andrewerrington/challenger_300_glareshield/README.md

# challenger_300_glareshield
Project to interface the Challenger 300 glare shield panel to X-Plane flight simulator.
