andrewerrington/challenger_300_glareshield/mcp/mcp.png

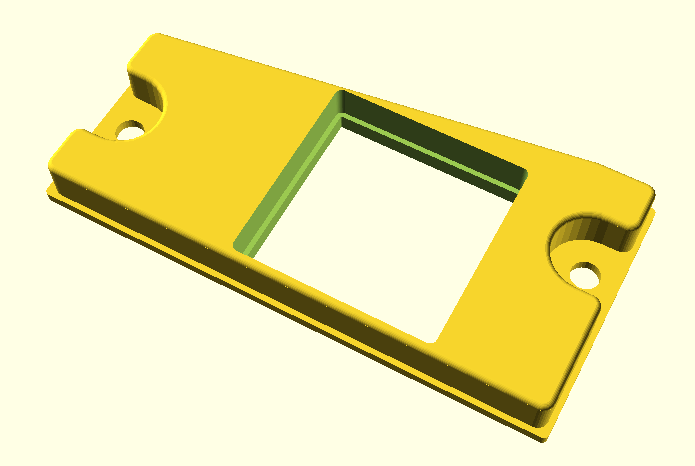
mcp/mcp.png
