andrewerrington/challenger_300_glareshield/mcp/mcp_bom.md

# Challenger 300 MCP panel parts		

Parts list is for one panel. Make two assemblies, mirror images of each other for Pilot (left) and Co-Pilot/FO (right).

Choose lasercut parts _or_ 3D printed part. Note that example links are for illustration only and should not be considered an endorsement of the product or supplier.

Lasercut panel assembly (from `mcp.dxf`)
|Qty | Description | Notes | Example link |
| --- | --- | --- | --- |
| 1	| Panel cut from 1.5mm (1/16”) acrylic | 1.5mm, 1.6mm or 1/16” material ok. Use _panel_, _panel_cut_, and _fasteners_panel_ layers.|
| 1	| Intermediate fascia piece cut from 3mm (1/8”) MDF | 3mm, 3.2mm, or 1/8” material ok. Use _fascia_outline_, _fascia_cut_, and _fasteners_fascia_ layers. |
| 1 | Top fascia piece cut from 3mm (1/8”) MDF | 3mm, 3.2mm, or 1/8” material ok. Use _fascia_outline_ and _fascia_cut_ layers. |
| 1 | Switch spacer cut from 1mm acrylic | Use _fascia_cut_ and _panel_cut_ layers to make thin, square spacer/packer. |
| 2 | M3x6 self-tapping screw | Attach panel to fascia. | https://www.aliexpress.com/item/1005003414944213.html
| 2 | M3x8 self-tapping screw | Hold perf board mount. | https://www.aliexpress.com/item/1005003414944213.html

or

3D printed panel assembly (from `mcp.stl`, created by `mcp.scad`)
|Qty | Description | Notes | Example link |
| --- | --- | --- | --- |
| 1 | 3D printed panel | Print `mcp.stl`. Mirror STL file for other side. |
| 2 | M3x8 self-tapping screw| Hold perf board mount. | https://www.aliexpress.com/item/1005003414944213.html

Common components
|Qty | Description | Notes | Example link |
| --- | --- | --- | --- |
| 1 | Perf board mount | Print from `perf_board_mount.stl`, any colour. |
| 1 | KF2510 header, right-angle, 4-way | For LEDs connection. | https://www.aliexpress.com/item/32963887703.html
| 1 | KF2510 header, right-angle, 2-way | For switch connection. | https://www.aliexpress.com/item/32963887703.html
| 1 | 2x8cm perfboard | Cut down to 7 holes long, plus edge with mounting holes. | https://www.aliexpress.com/item/1005006100148769.html
| 2 | 330R resistor | | https://www.aliexpress.com/item/1005005430821987.html
| 3 | LED, red, 3mm, ultra bright | | https://www.aliexpress.com/item/1954971920.html
| 3 | LED, yellow, 3mm, ultra bright | | https://www.aliexpress.com/item/1954971920.html
| | Thin hookup wire |
| 1 | 33mm square arcade button, white with black surround | | https://www.aliexpress.com/item/32708530409.html
| 2 | 4.8mm spade connector and wire | Optional | https://www.aliexpress.com/item/1005001851398735.html
| 1 | LED holder | Print from `mcp_LED_holder.stl`, cold white. |
| 1 | LED baffle | Print from `mcp_LED_baffle.stl`, black. |
| 2 | Opal acrylic 19x8.9x3mm | 3.2mm, or 1/8” material ok. Lasercut from `mcp_acrylic_insert.dxf` |
| 3 | Decal | Laser etch or print `mcp_decal.dxf` on laser transparency film and cut to 21.4x21.4mm. |
| 1 | Filter | Cut 21.4x21.4 mm square of 20% window tinting film. |
| 1	| KF2510 receptacle, 4-way | For LEDs connection. | https://www.aliexpress.com/item/32853172050.html
| 1 | KF2510 receptacle, 2-way | For switch connection. | https://www.aliexpress.com/item/32853172050.html
| 2 | DZUS fasteners | To suit sim panel construction technique. |
| 1 | Filing jig | Print from `mcp_filing_jig.stl`, any colour. Only one needed. |
| | | Spray paint: primer, matt white, matt black, matt clear, other colours as required.|
