andrewerrington/challenger_300_glareshield/COCKPIT_LIGHTS/COCKPIT_LIGHTS_fo.dxf

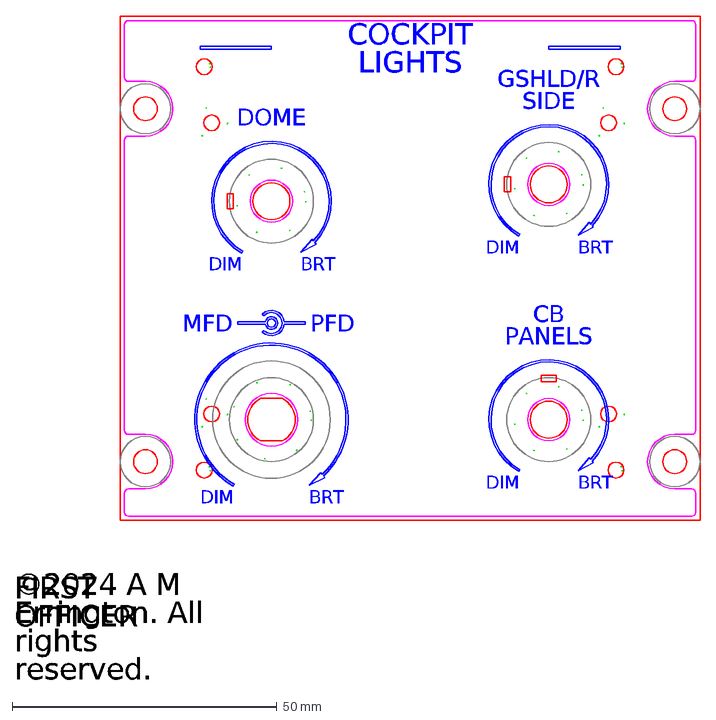
[picture p2: CAD file, 2024-09-26]
COCKPIT_LIGHTS/COCKPIT_LIGHTS_fo.dxf
COCKPIT LIGHTS
DOME
MFD
PFD
CB PANELS
GSHLD/R SIDE
DIM
BRT
FIRST OFFICER
©2024 A M Errington. All rights reserved.
