andrewerrington/challenger_300_glareshield/mcp/mcp_filing_jig.stl

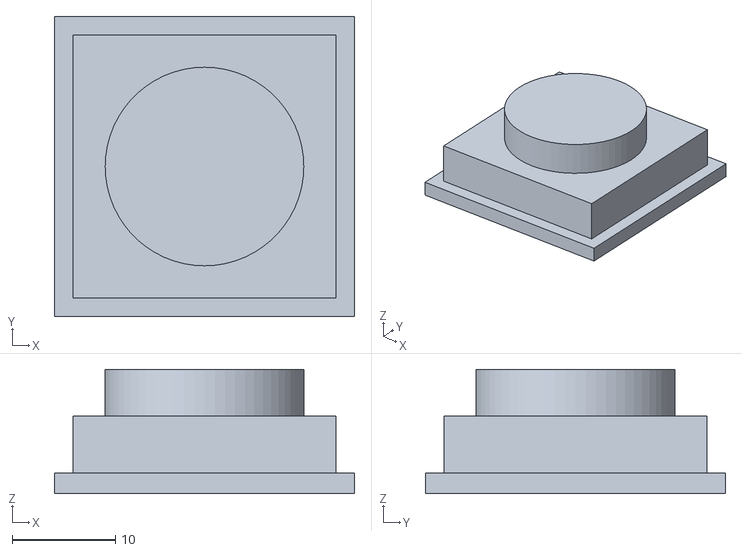
[picture p3: CAD file, 2024-04-25]
mcp/mcp_filing_jig.stl
29.0 x 29.0 x 12.0
