andrewerrington/challenger_300_glareshield/COCKPIT_LIGHTS/COCKPIT_LIGHTS_pilot.dxf

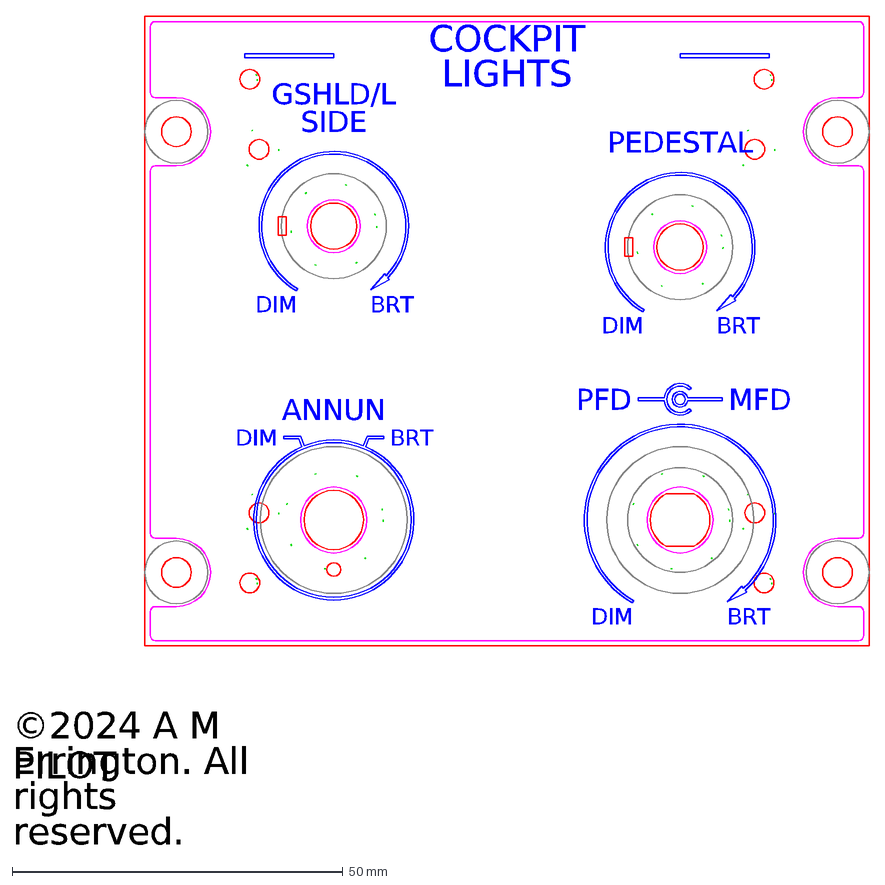
[picture p4: CAD file, 2024-09-26]
COCKPIT_LIGHTS/COCKPIT_LIGHTS_pilot.dxf
COCKPIT LIGHTS
PEDESTAL
MFD
PFD
ANNUN
GSHLD/L SIDE
DIM
BRT
PILOT
©2024 A M Errington. All rights reserved.
