andrewerrington/challenger_300_glareshield/mcp/mcp_decal.dxf

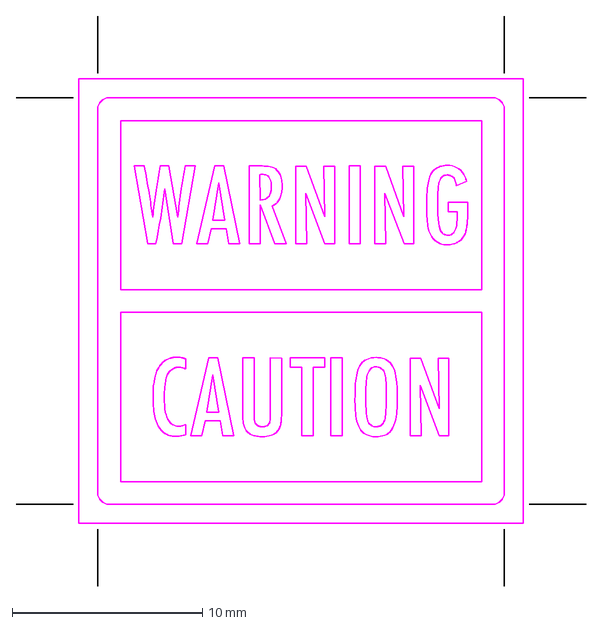
[picture p5: CAD file, 2024-04-25]
mcp/mcp_decal.dxf
30.0 x 30.0 mm
