andrewerrington/challenger_300_glareshield/mcp/mcp_acrylic_insert.dxf

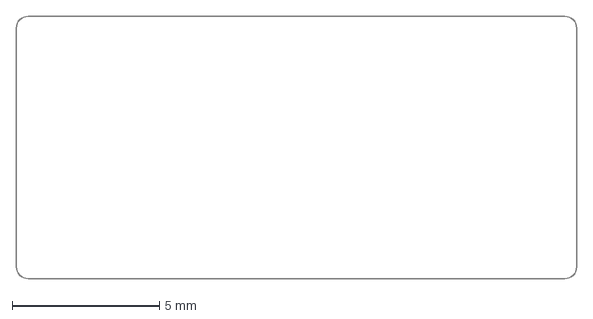
[picture p6: CAD file, 2024-04-25]
mcp/mcp_acrylic_insert.dxf
19.0 x 8.90 mm
