andrewerrington/challenger_300_glareshield/mcp/mcp_LED_holder.stl

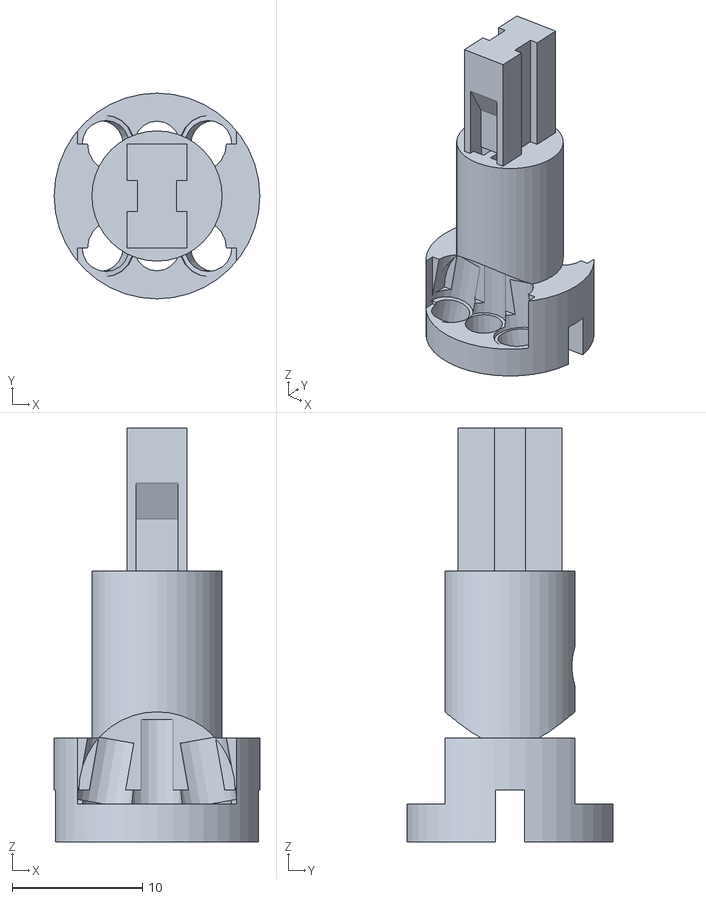
[picture p7: CAD file, 2024-04-25]
mcp/mcp_LED_holder.stl
15.8 x 15.8 x 31.8
