andrewerrington/challenger_300_glareshield/mcp/perf_board_mount.stl

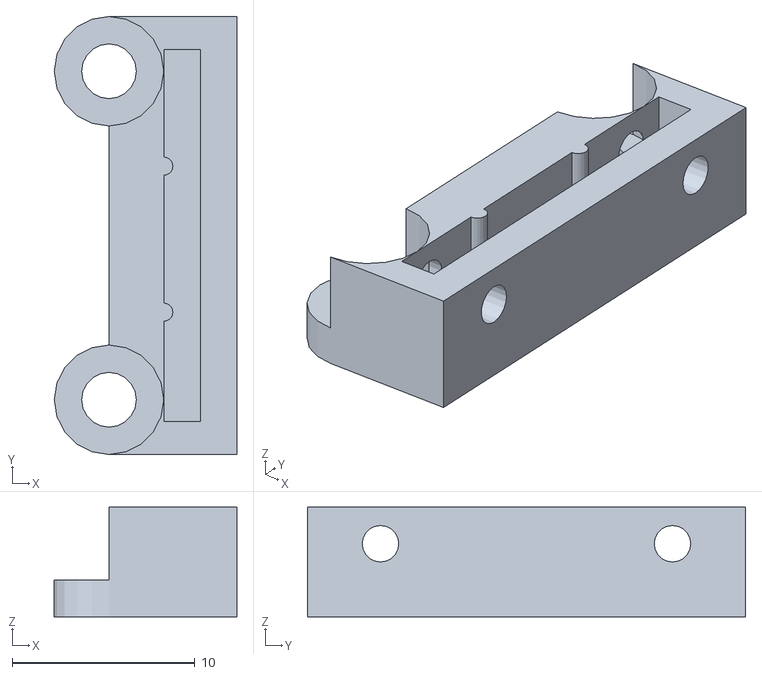
[picture p8: CAD file, 2024-04-25]
mcp/perf_board_mount.stl
10.0 x 24.0 x 6.00
