andrewerrington/challenger_300_glareshield/mcp/mcp.stl

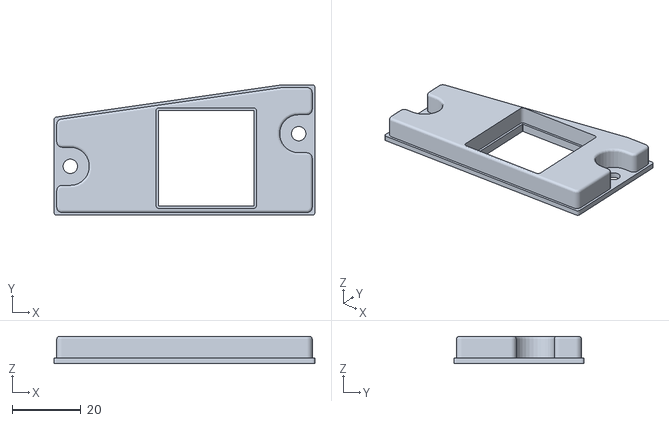
[picture p9: CAD file, 2024-04-25]
mcp/mcp.stl
76.2 x 38.1 x 7.93
