andrewerrington/challenger_300_glareshield/mcp/mcp_LED_baffle.stl

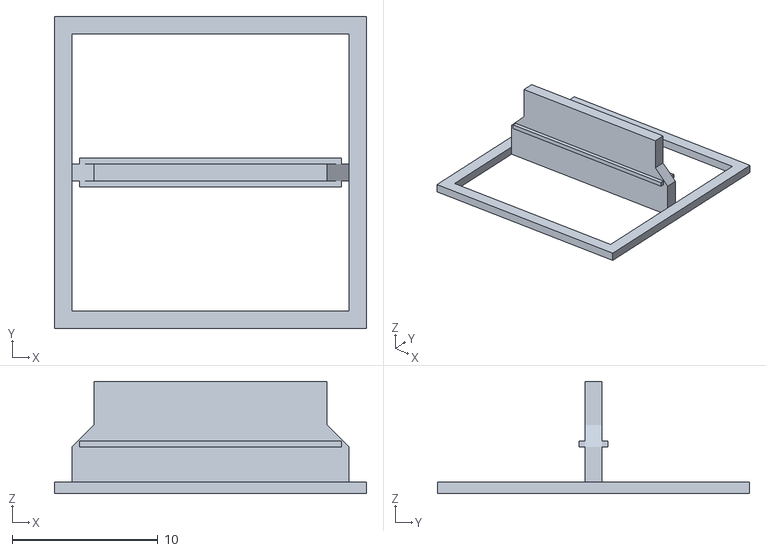
[picture p10: CAD file, 2024-04-12]
mcp/mcp_LED_baffle.stl
21.4 x 21.4 x 7.70
