andrewerrington/challenger_300_glareshield/(list of files, cad)

Other CAD files:
mcp/mcp_filing_jig.scad
mcp/mcp_LED_baffle.scad
mcp/mcp_LED_holder.scad
mcp/mcp.dxf
