andrewerrington/challenger_300_glareshield/(threads)

Thread 5 (2025-08-27):

AP button action

andrewerrington, 2025-08-27:
Pressing the “AP“ button should toggle the autopilot on and off. To be more specific, pressing the “AP” button seems to be turning the “YD” instead of the “AP.” This is partially correct because pressing the “AP“ button should turn on the “YD” as well as the “AP” (assuming the yaw damper was not already turned on in the first place).

andrewerrington, 2025-08-27:
Currently, pressing AP causes the following commands to be issued:
`sim/autopilot/servos_toggle`
`sim/autopilot/fdir_servos_toggle`
`sim/autopilot/autothrottle_off`

Action: Use _DataRefTool_ to observe sim actions when in-sim AP button is pressed. Modify firmware if necessary. Consider adding additional commands if necessary.

Thread 7 (2025-08-27):

Pitch wheel

andrewerrington, 2025-08-27:
The vertical speed rotor feels too lightweight, and too easy to move which can make it hard to select the proper rate of climb or descent. This component and the ALT knob get the most use, so may be worth improving.

andrewerrington, 2025-08-27:
Action: Investigate alternative scroll wheel rotary encoder to replace current (Kailh). Research indicates that Alps or TTC Gold may be more 'clicky'. Also, consider adding some mass to 3D-printed pitch wheel by embedding steel nuts, ball bearings, or other weights inside.

The ALT knob has the current behaviour:
When rotated clockwise, issues the command `cl300/autop/autop_alt_dial_up`
When rotated anticlockwise, issues the command `cl300/autop/autop_alt_dial_dn`
When pressed, issues the command `sim/autopilot/altitude_hold`

Action: Use _DataRefTool_ to observe sim actions when in-sim ALT knob is pressed or turned. Modify firmware if necessary. Consider adding additional commands to replicate real aircraft behaviour:

- When rotated without pressing - change altitude by +/- 1000'
- When rotated while pressed - change altitude by +/- 100'
- When pressed without rotating - Set altitude bug to current altitude

Thread 8 (2025-09-02):

ALT knob

andrewerrington, 2025-09-02:
The ALT knob (marked "PUSH CANCEL") has the current behaviour in glareshield firmware:
When rotated clockwise, issues the command `cl300/autop/autop_alt_dial_up`
When rotated anticlockwise, issues the command `cl300/autop/autop_alt_dial_dn`
~When pressed, issues the command `sim/autopilot/altitude_hold`~ (Incorrect, that is the ALT button).
When pressed, no action (the ALT knob can not be pressed in the simulator).

The behaviour of the ALT knob in the real aircraft is as follows:
- When rotated without pressing - change altitude by +/- 1000'
- When rotated while pressed - change altitude by +/- 100'
- When pressed without rotating - Set altitude bug to current altitude

andrewerrington, 2025-09-02:
Currently, when the ALT knob is rotated, altitude is changed by +/- 100'

Action: Use _DataRefTool_ to observe sim actions when in-sim ALT knob is pressed or turned. Modify firmware if necessary. Consider adding additional commands to replicate real aircraft behaviour.
Action: Find simulator command/dataref that sets the altitude bug to current altitude.

andrewerrington, 2025-10-04:
Confirmation that ALT knob does not have any complicated assembly. It operates as a typical rotary encoder with pushbutton, thus the current design is fine. There are three actions that can be detected:

1 Turn without pushing
2 Turn while pushing
3 Pushing without turning

These can all be detected in firmware, and different commands issued. However, currently in the firmware pushing the knob has no effect, and in the simulator there is no way to "push" the knob.
