andrewerrington/challenger_300_glareshield/mcp/mcp_schematic.pdf

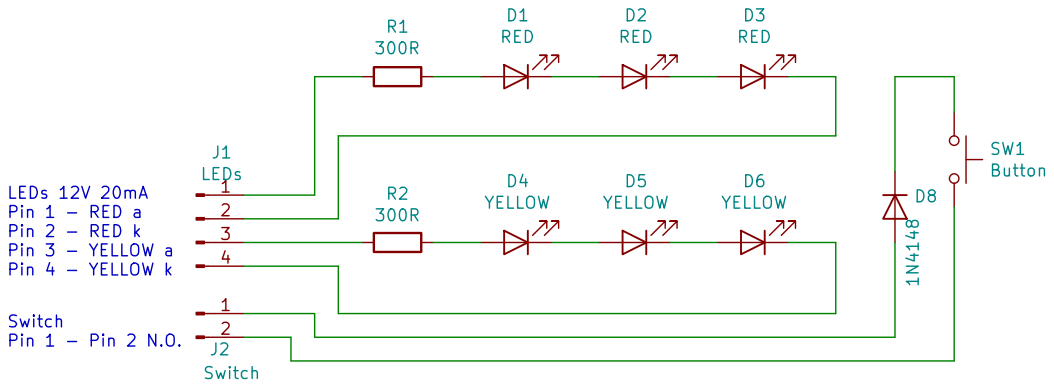
[picture p11: page 1]

File: master_caution_panel.sch Sheet: /
Id: 1/1 Title: Challenger 300 Glare Shield Master Caution
