andrewerrington/challenger_300_glareshield/(commit log)

2024-04-12 Update and rename bom.md to mcp_bom.md
2024-04-25 Update and rename mcp/master_caution_panel.dxf to mcp.dxf
    [mcp.dxf]
2024-04-25 Update and rename mcp.dxf to mcp/mcp.dxf
    [mcp.dxf]
2024-04-25 Update and rename 33mm_switch_LED_baffle_short.scad to mcp_LED_baffle_short.scad
    [mcp_LED_baffle_short.scad]
2024-04-25 Update and rename mcp_LED_baffle_short.scad to mcp_LED_baffle.scad
    [mcp_LED_baffle.scad]
2024-04-25 Update and rename 33mm_switch_tri_LED_holder.scad to mcp_LED_holder.scad
    [mcp_LED_holder.scad]
2024-04-25 Update and rename 33mm_filing_jig.scad to mcp_filing_jig.scad
    [mcp_filing_jig.scad]
2024-04-25 Update and rename 33mm_switch_tri_LED_holder.stl to mcp_LED_holder.stl
    [mcp_LED_holder.stl]
2024-04-25 Update and rename 33mm_switch_LED_baffle_short.stl to mcp_LED_baffle_short.stl
    [mcp_LED_baffle_short.stl]
2024-04-25 Update and rename mcp_LED_baffle_short.stl to mcp_LED_baffle.stl
    [mcp_LED_baffle.stl]
2024-04-25 Update and rename 33mm_filing_jig.stl to mcp_filing_jig.stl
    [mcp_filing_jig.stl]
2024-09-26 Add files via upload
    DXF files for fabricating Pilot and First Officer COCKPIT LIGHTS panels.
    [COCKPIT_LIGHTS_fo.dxf, COCKPIT_LIGHTS_pilot.dxf]
2025-08-27 Update glare_shield_interface.ino
    Added code to detect VS or PTCH mode and make pitch wheel behave correctly in each case.
    [glare_shield_interface.ino]
2026-01-14 Fix AP button action
    v0.4 intends to fix the AP button action by subscribing to sim/cockpit/autopilot/autopilot_mode and performing a different action when mode is 2.
2026-01-17 Update glare_shield_interface.ino
    AP button fix is simpler than I had it.
