andrewerrington/challenger_300_glareshield/(notices)

Notices in the files:
COCKPIT_LIGHTS/COCKPIT_LIGHTS_pilot.dxf:
b0|i0|c0|p0;\H4;\U+00a92024 A M Errington. All rights reserved.
